Balaganoff/MFJ-993B-Remote-Control/(commit log)

2026-09-09 Add docs/wiring.md
2026-09-15 Sample LCD bus immediately inside E high window
2026-09-15 Fix immediate HTTP OTA timeout race
    [MFJ993B_LCD_Diagnostic.ino]
2026-09-16 Adjust sample delay and display idle time
2026-09-16 Optimize sample delay and display settings
    Reduced sample delay and display idle time for improved responsiveness. Adjusted LCD version handling and optimized screen rendering logic.
2026-09-30 Harden LCD capture and add safe decoder reset
    [MFJ993B_Remote_Control.ino]
2026-09-30 Fix short-E LCD capture and expose firmware status
    [MFJ993B_Remote_Control.ino]
2026-09-30 Show ESP32 firmware version after connect and OTA
2026-10-01 Restore proven LCD sample path in v1.2.2
